grodansparadis/can4vscp-power-injector/kicad/big_screw_terminal/power_injector_rev_c.kicad_pcb

## KiCad design kicad/big_screw_terminal/power_injector_rev_c.kicad_pcb (2026-05-05)

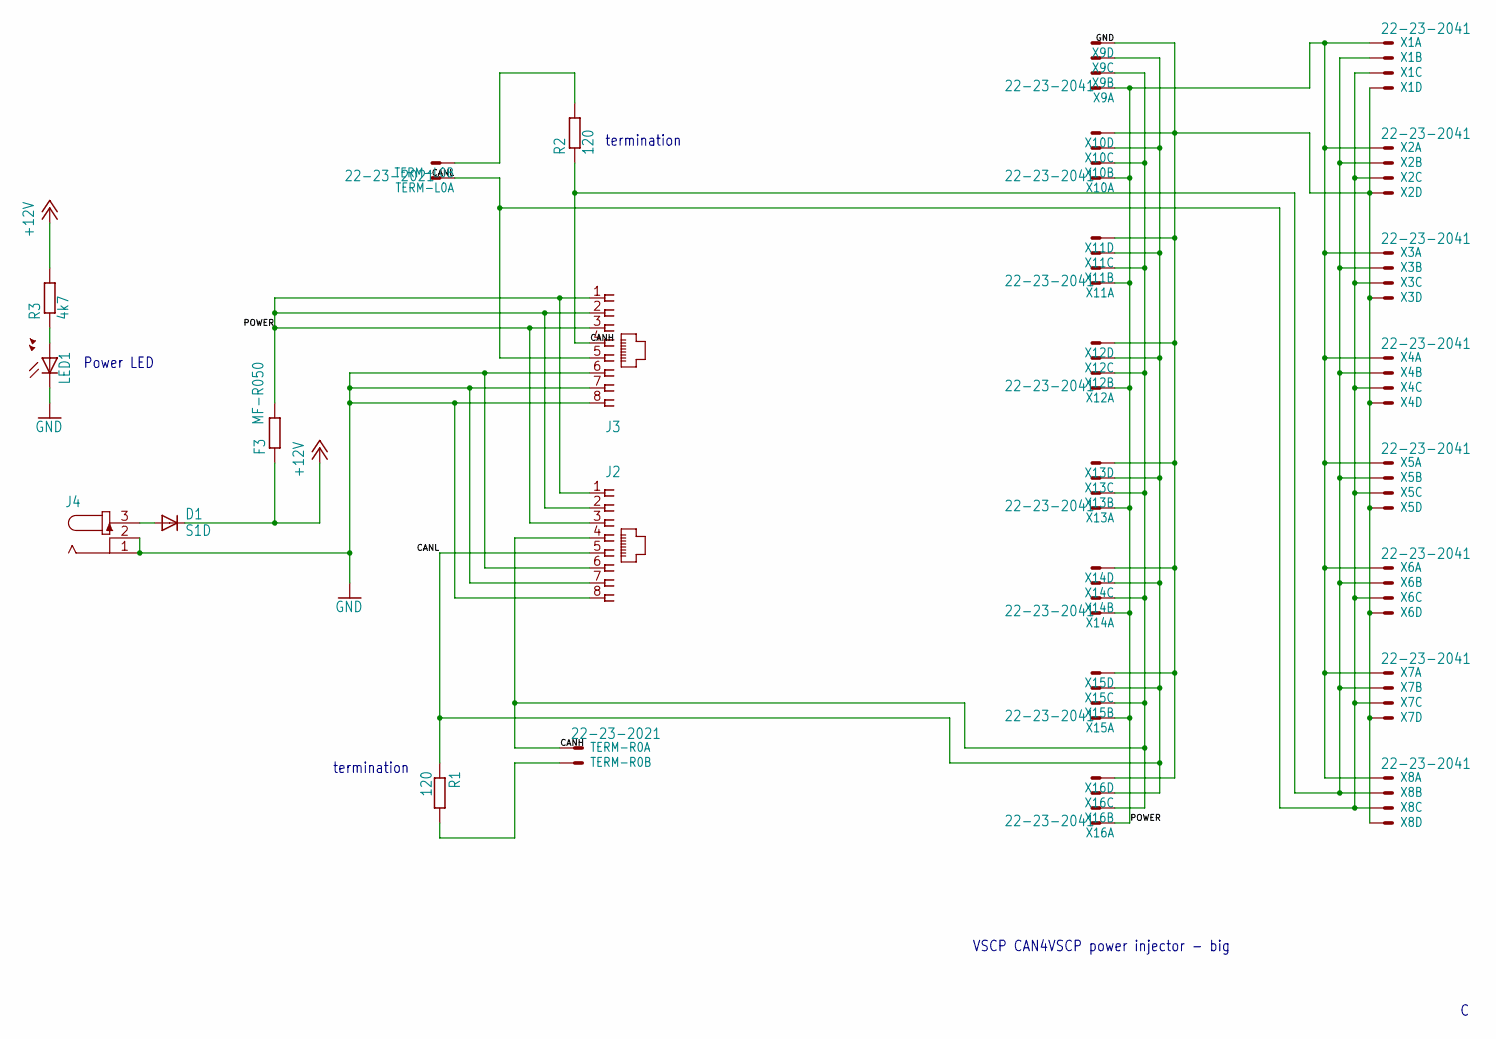
[picture p2: schematic power_injector_rev_c.kicad_sch]

Parts:
D1: S1D; SMB
F3: MF-R050; 0204_5
J2, J3: A00-108-220-450; RJ-45
J4: JACK-PLUG0; SPC4077
LED1: LEDCHIP-LED0805; CHIP-LED0805
R1, R2: 120; R0805
R3: 4k7; R0805
TERM-L0: 22-23-2021
TERM-R0: 22-23-2021
X1, X2, X3, X4, X5, X6, X7, X8, X9, X10, X11, X12, X13, X14, X15, X16: 22-23-2041

Connections:
+12V: D1.C, F3.1, R3.2
CANH: J2.4, J3.4, R2.1, TERM-R0.1, X1.2, X2.2, X3.2, X4.2, X5.2, X6.2, X7.2, X8.2, X9.2, X10.2, X11.2, X12.2, X13.2, X14.2, X15.2, X16.2
CANL: J2.5, J3.5, R1.1, TERM-L0.1, X1.3, X2.3, X3.3, X4.3, X5.3, X6.3, X7.3, X8.3, X9.3, X10.3, X11.3, X12.3, X13.3, X14.3, X15.3, X16.3
GND: J2.6, J2.7, J2.8, J3.6, J3.7, J3.8, J4.1, J4.2, LED1.C, X1.4, X2.4, X3.4, X4.4, X5.4, X6.4, X7.4, X8.4, X9.4, X10.4, X11.4, X12.4, X13.4, X14.4, X15.4, X16.4
unnamed: LED1.A, R3.1
unnamed: R1.2, TERM-R0.2
unnamed: D1.A, J4.3
unnamed: R2.2, TERM-L0.2
POWER: F3.2, J2.1, J2.2, J2.3, J3.1, J3.2, J3.3, X1.1, X2.1, X3.1, X4.1, X5.1, X6.1, X7.1, X8.1, X9.1, X10.1, X11.1, X12.1, X13.1, X14.1, X15.1, X16.1

Notes on the sheet:
termination
VSCP CAN4VSCP power injector - big
Power LED

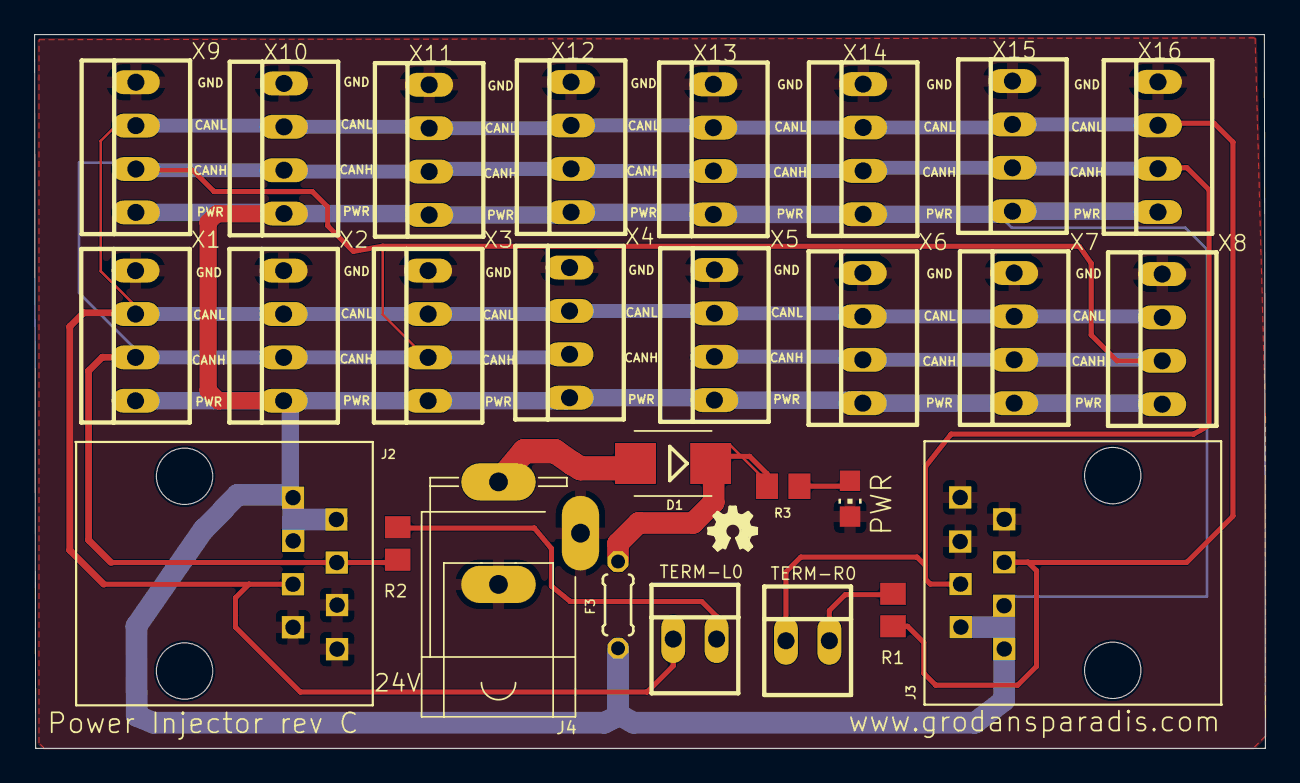
[picture p3: board kicad/big_screw_terminal/power_injector_rev_c.kicad_pcb from above]

Board: 2 copper layers, 72.1 x 41.8 mm, 28 parts (0 on the bottom side), 9 nets.

Other parts of the board:
U$1: OSHW_FILLX100_NOTEXT
