grodansparadis/can4vscp-power-injector/kicad/mini_screw_terminal/power_injector_rev_c.kicad_pcb

## KiCad design kicad/mini_screw_terminal/power_injector_rev_c.kicad_pcb (2026-05-05)

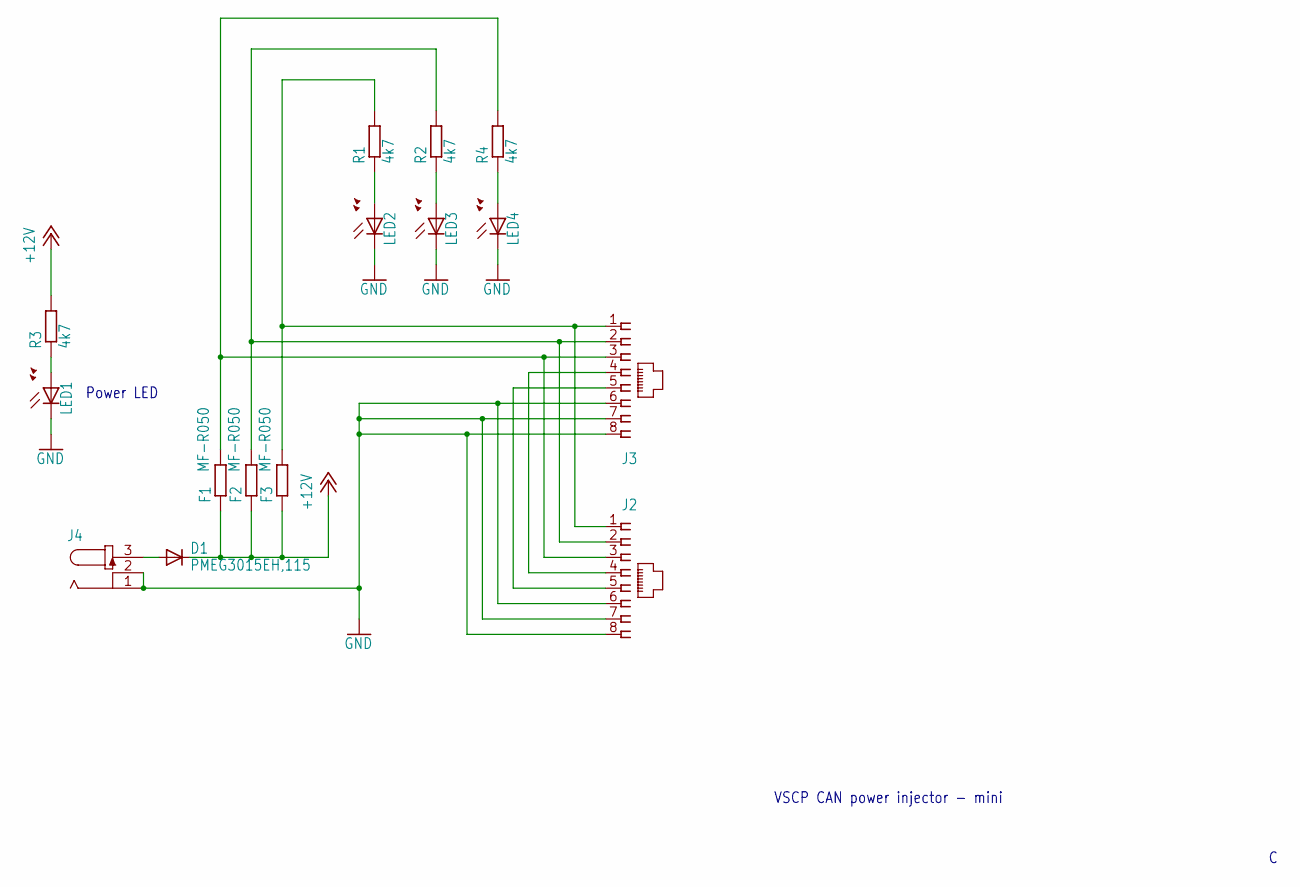
[picture p4: schematic power_injector_rev_c.kicad_sch]

Parts:
D1: PMEG3015EH,115; SMB
F1, F2, F3: MF-R050; 0204_5
J2, J3: A00-108-220-450; RJ-45
J4: JACK-PLUG0; SPC4077
LED1, LED2, LED3, LED4: LEDCHIP-LED0805; CHIP-LED0805
R1, R2, R3, R4: 4k7; R0805

Connections:
+12V: D1.C, F1.1, F2.1, F3.1, R3.2
GND: J2.6, J2.7, J2.8, J3.6, J3.7, J3.8, J4.1, J4.2, LED1.C, LED2.C, LED3.C, LED4.C
unnamed: LED3.A, R2.1
unnamed: LED1.A, R3.1
unnamed: J2.4, J3.4
unnamed: J2.5, J3.5
unnamed: LED4.A, R4.1
unnamed: LED2.A, R1.1
unnamed: D1.A, J4.3
PWR1: F3.2, J2.1, J3.1, R1.2
PWR2: F2.2, J2.2, J3.2, R2.2
PWR3: F1.2, J2.3, J3.3, R4.2

Notes on the sheet:
Power LED
VSCP CAN power injector - mini

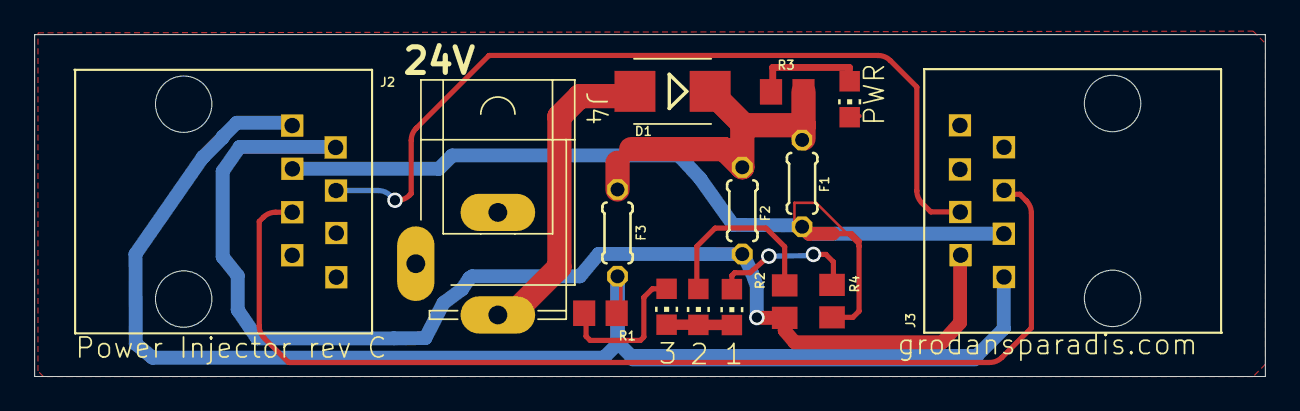
[picture p5: board kicad/mini_screw_terminal/power_injector_rev_c.kicad_pcb from above]

Board: 2 copper layers, 72.0 x 20.0 mm, 15 parts (0 on the bottom side), 12 nets.
